GeorgeStanov/Proiect1_ETTI/Plan de plantare/Plan_Plantare_432E_bb.jpg

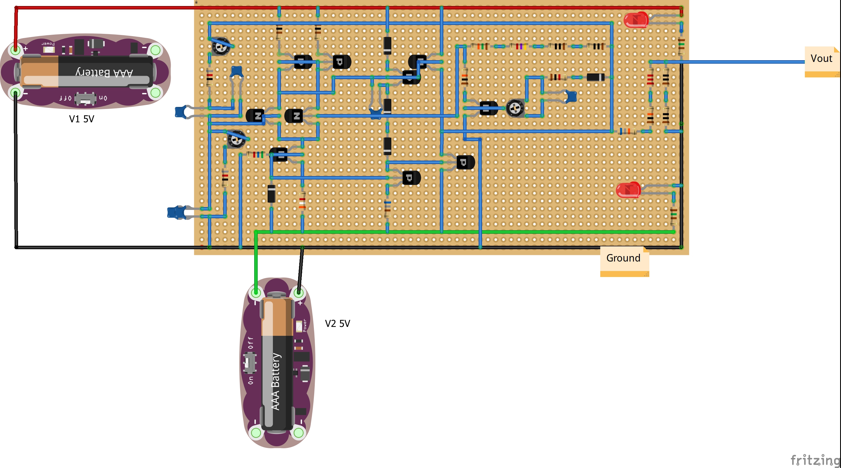
Plan de plantare/Plan_Plantare_432E_bb.jpg
