GeorgeStanov/Proiect1_ETTI/Proiect docs/Calcul analitic PSF.pdf

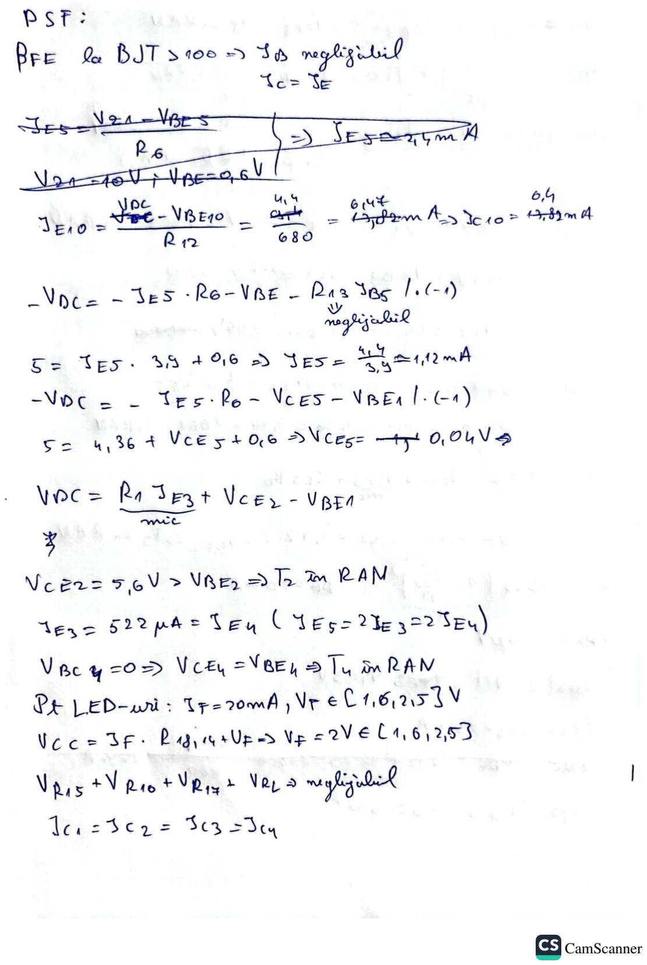
[picture p10: page 1]

CamScanner (https://v3.camscanner.com/user/download)

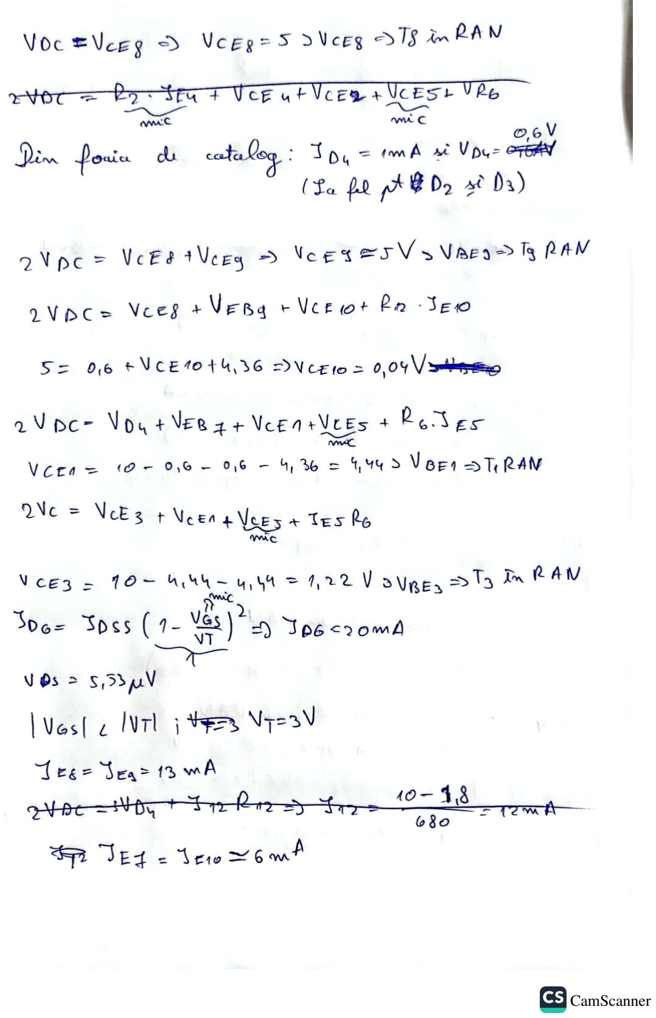
[picture p11: page 2]
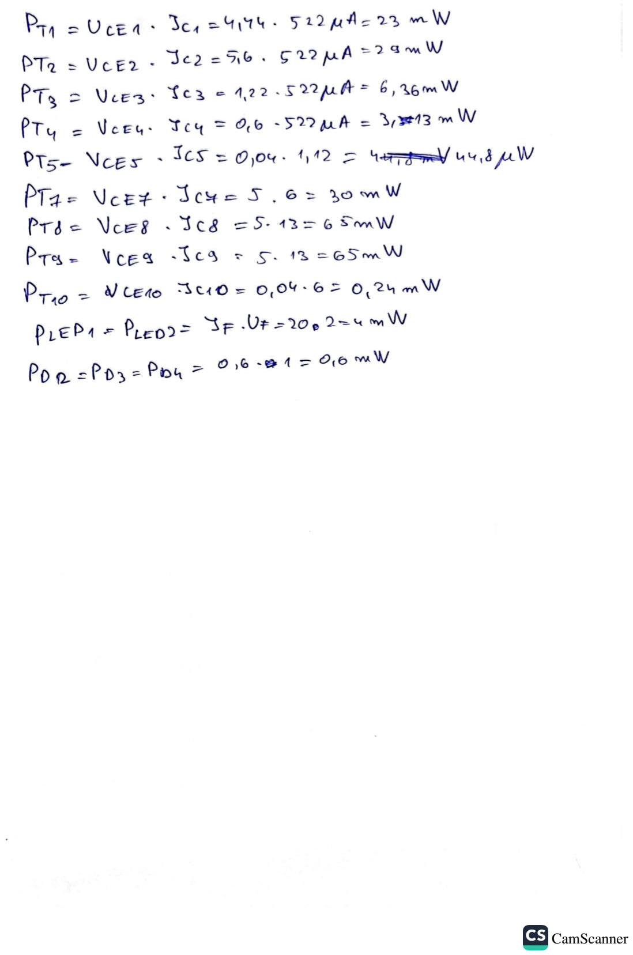
[picture p12: page 3]
