GeorgeStanov/Proiect1_ETTI/Proiect docs/Calcul curent alternativ.pdf

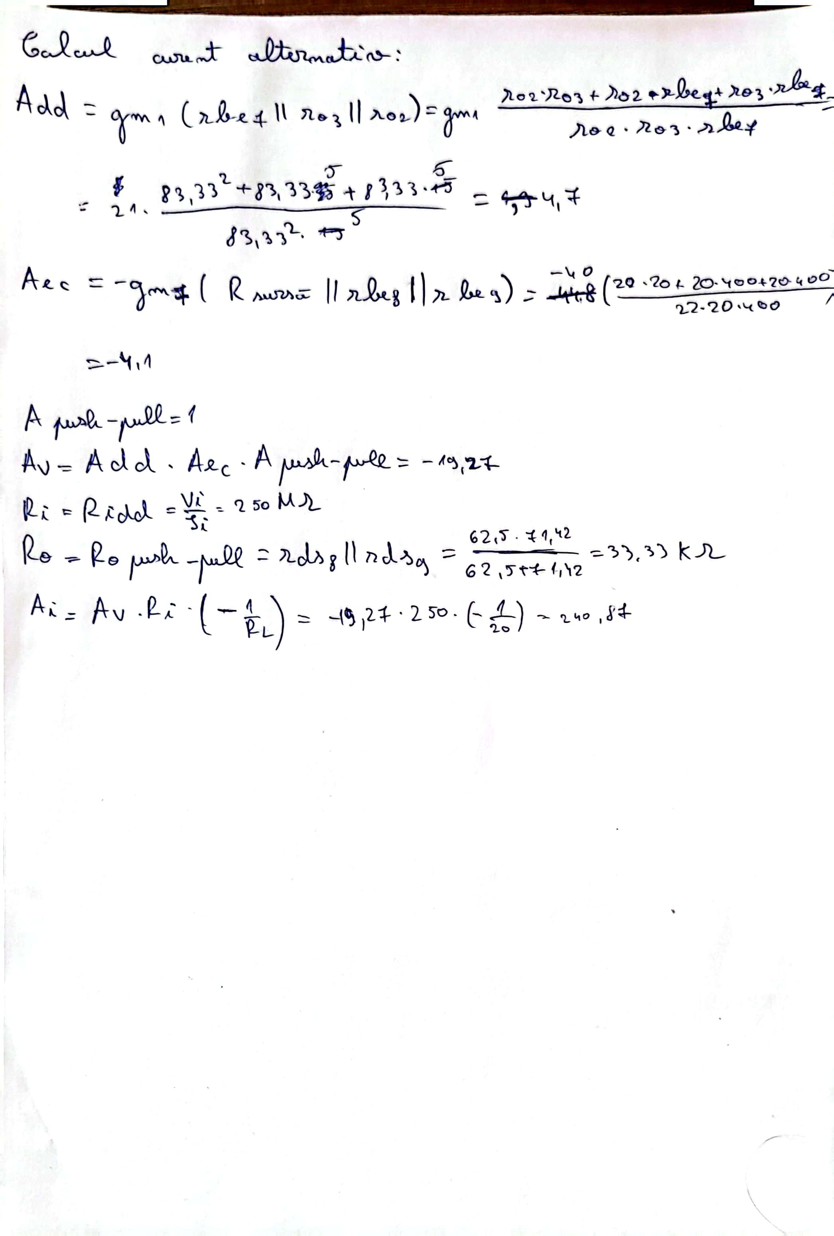
[picture p13: page 1]
