GeorgeStanov/Proiect1_ETTI/schema_bloc.png

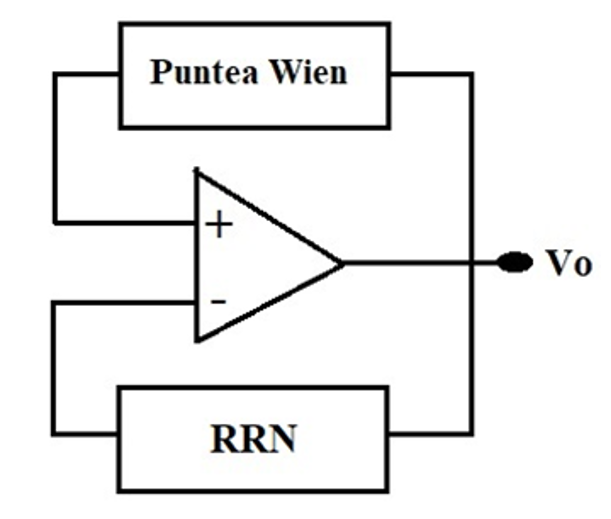
schema_bloc.png
