GeorgeStanov/Proiect1_ETTI/Schematics/schema electrica.png

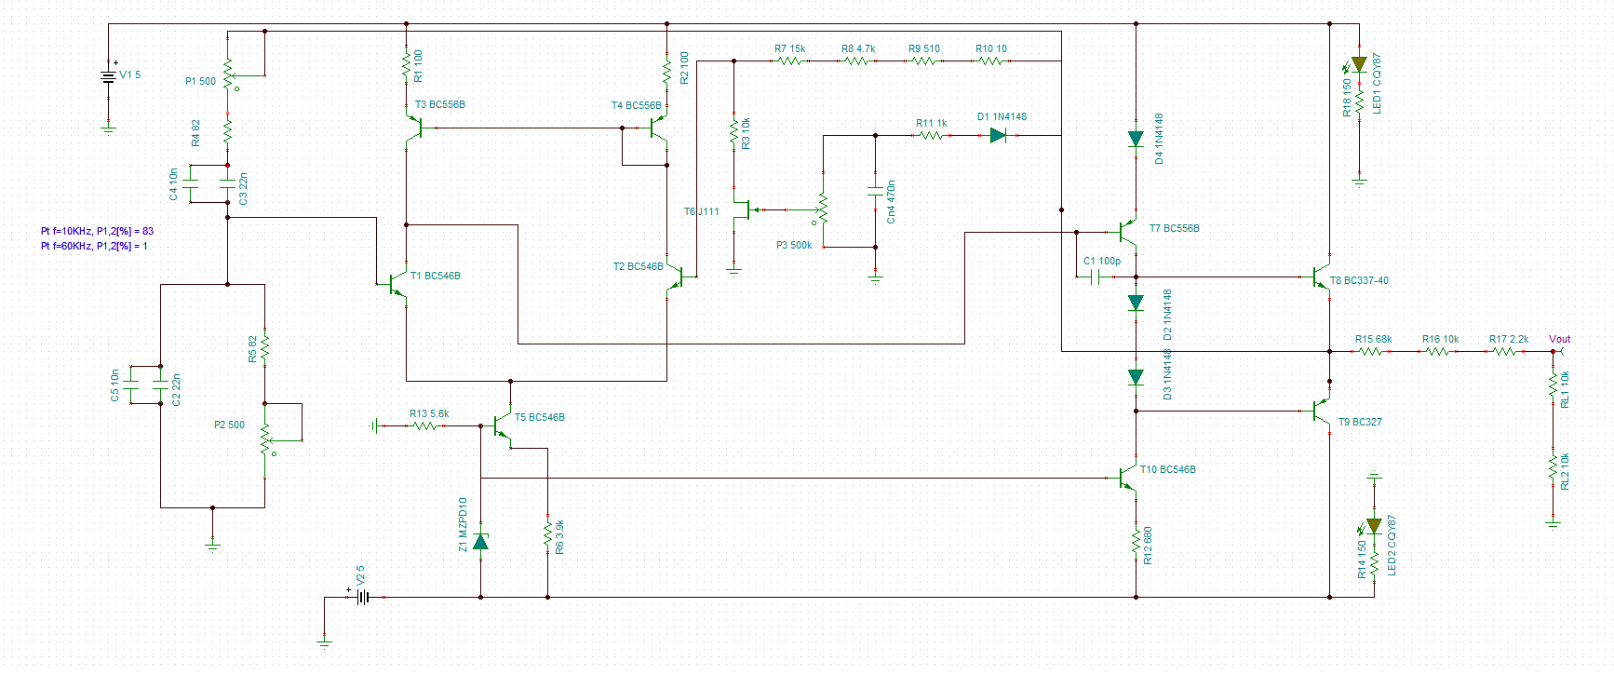
Schematics/schema electrica.png
