GeorgeStanov/Proiect1_ETTI/Schematics/schema_electrica.jpg

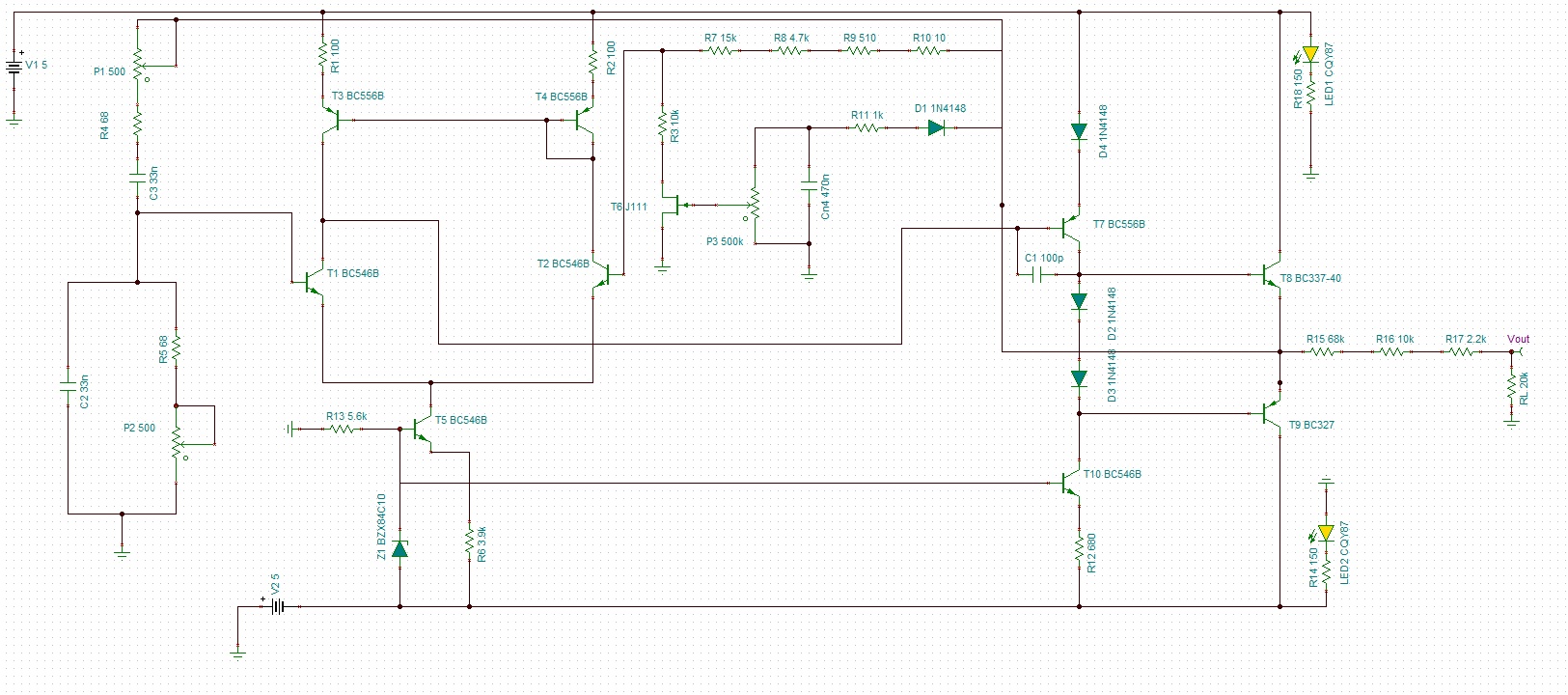
Schematics/schema_electrica.jpg
