GeorgeStanov/Proiect1_ETTI/Schematics/schema_electrica_CA.png

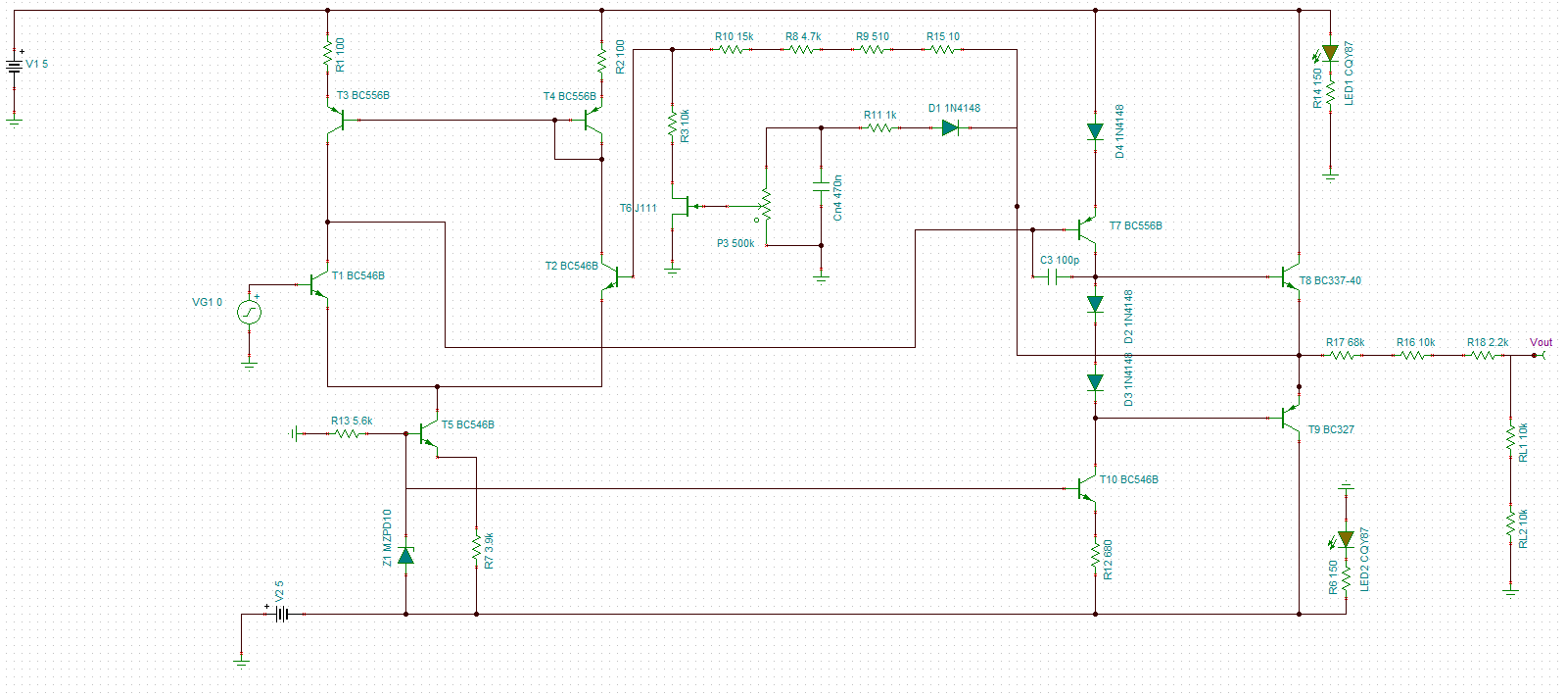
Schematics/schema_electrica_CA.png
