GeorgeStanov/Proiect1_ETTI/Simulations/forma de unda a semnalului de iesire pt fmin.png

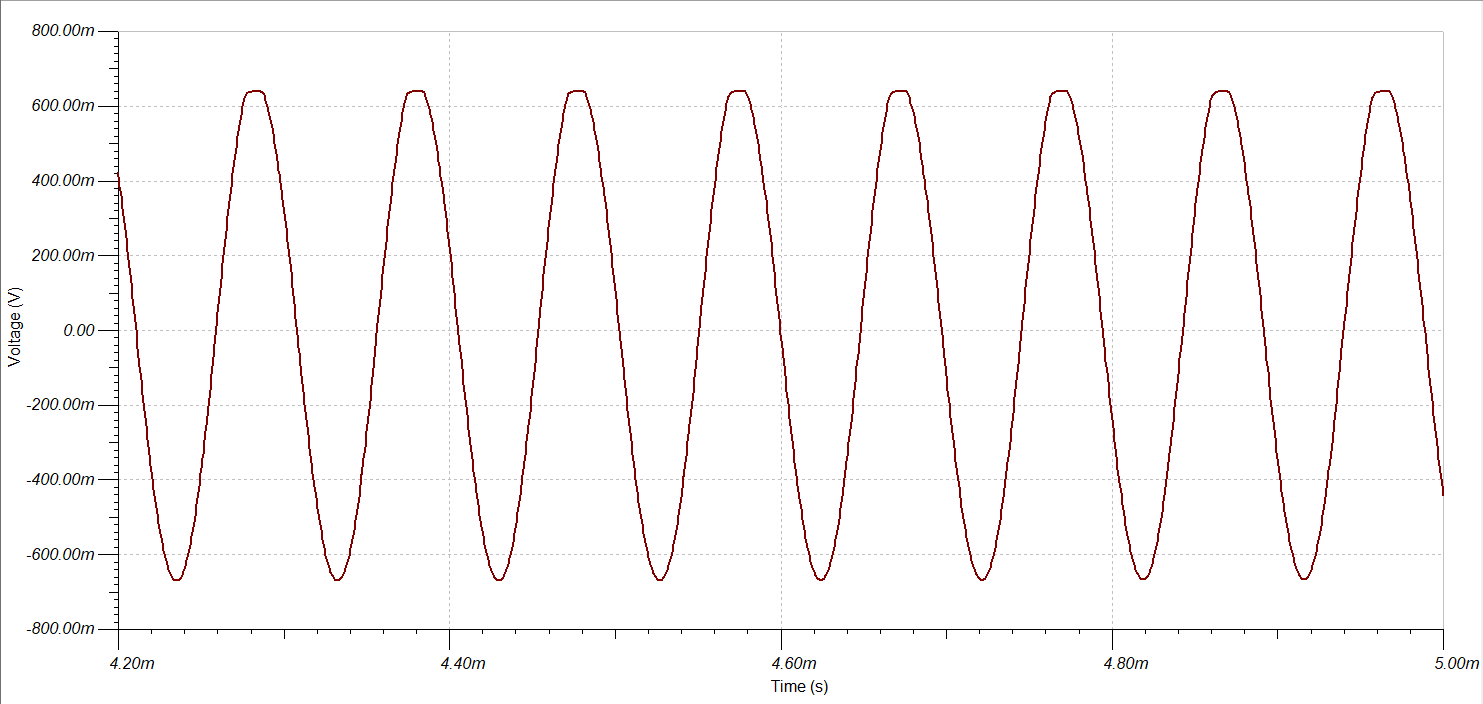
Simulations/forma de unda a semnalului de iesire pt fmin.png
