GeorgeStanov/Proiect1_ETTI/Simulations/Forma de undă a semnalului de ieșire pentru temperaturi cuprinse între -20 și 120 grade Celsius.png

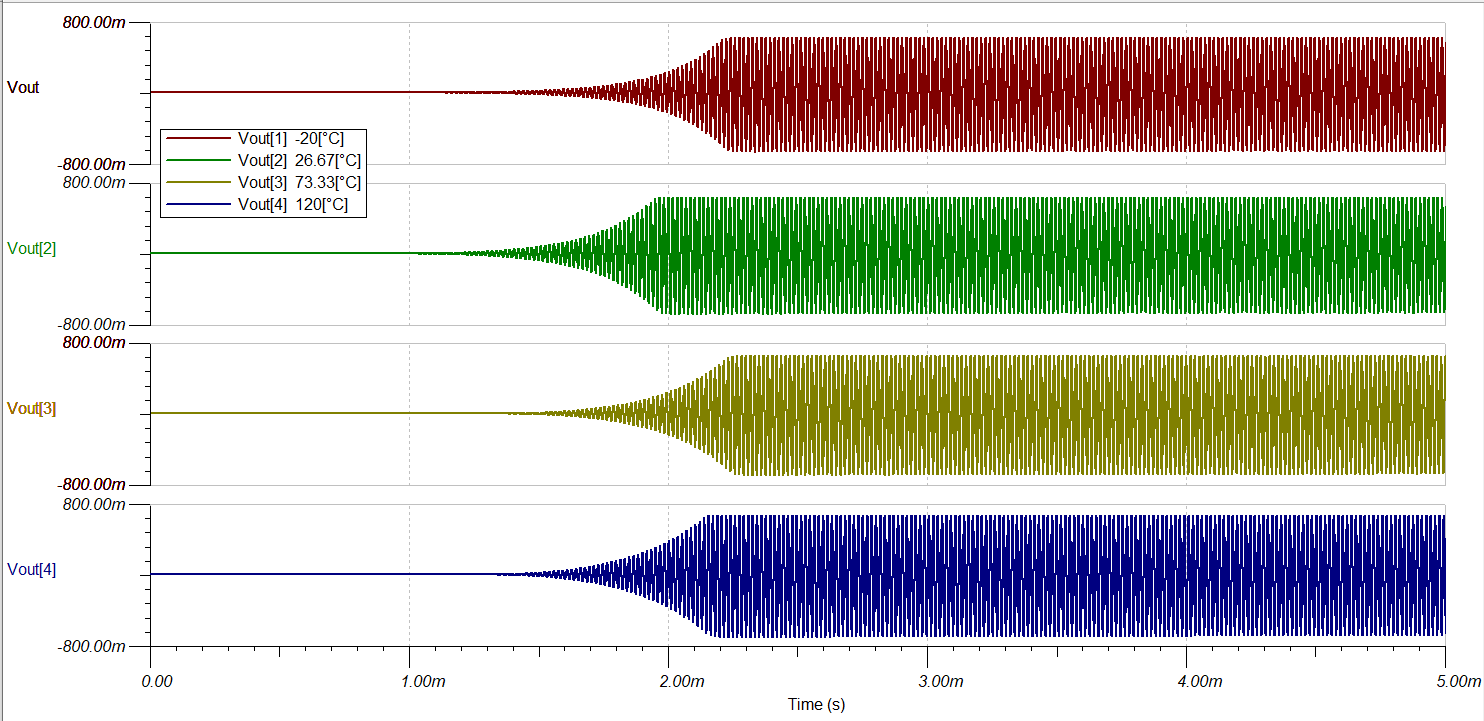
Simulations/Forma de undă a semnalului de ieșire pentru temperaturi cuprinse între -20 și 120 grade Celsius.png
