GeorgeStanov/Proiect1_ETTI/Simulations/Pornirea oscilațiilor și stabilizarea amplitudinii.jpg

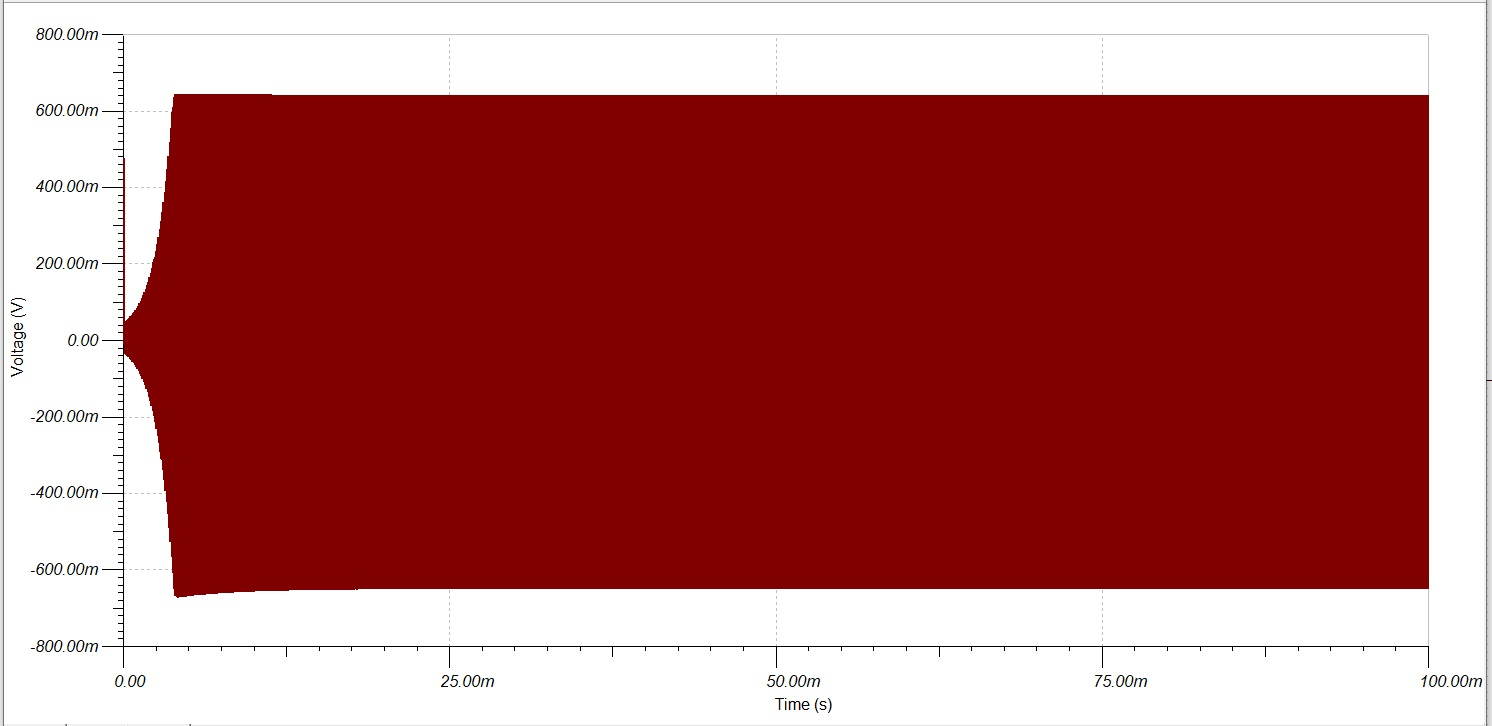
Simulations/Pornirea oscilațiilor și stabilizarea amplitudinii.jpg
