GeorgeStanov/Proiect1_ETTI/Simulations/Răspunsul în frecvență și faza circuitului în buclă deschisă.png

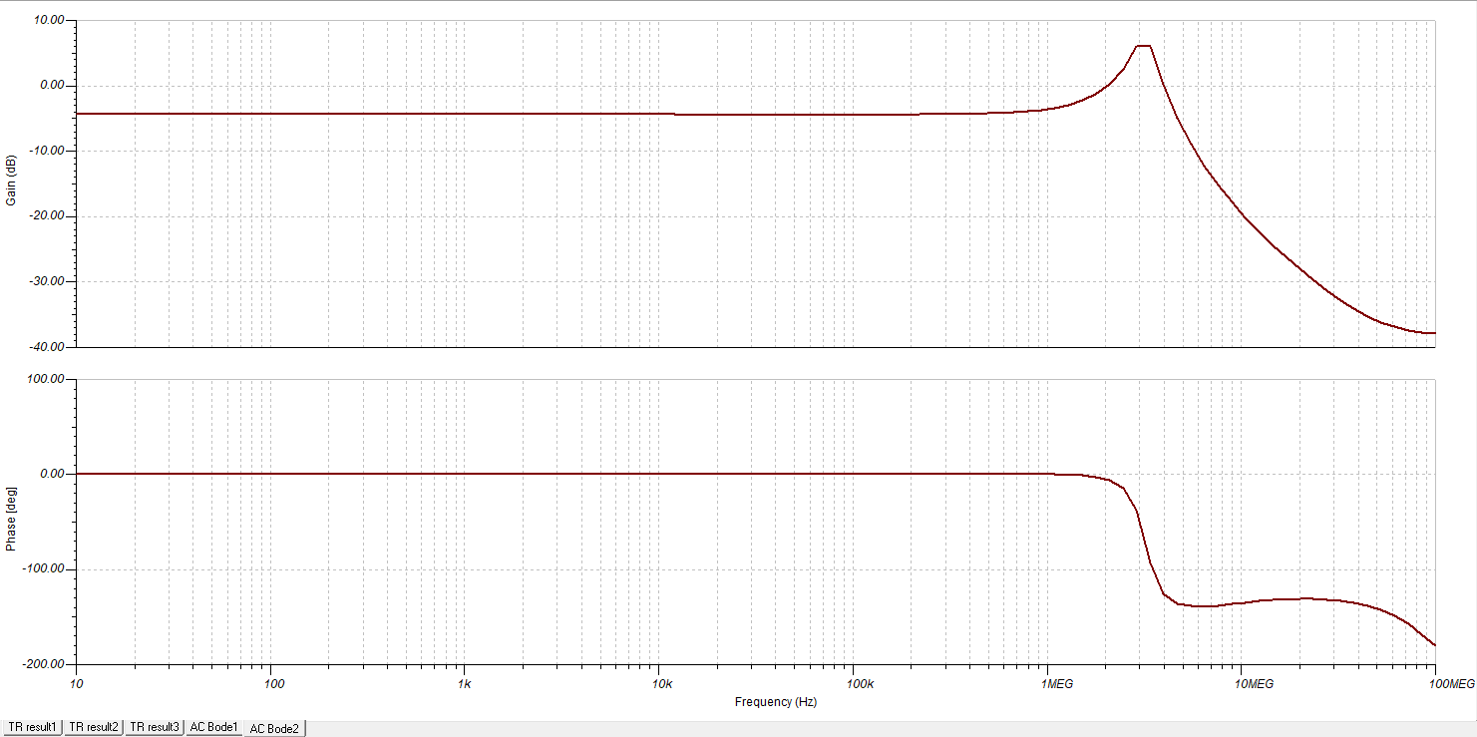
Simulations/Răspunsul în frecvență și faza circuitului în buclă deschisă.png
