GeorgeStanov/Proiect1_ETTI/Bill_of_Materials/Bill_of_Materials.xlsx

Anexa - Componente THD disponibile pentru realizarea proiectului P1 - tehnologie THT/Perfo-board - AU 2023-2024 Grupa 432E_Oscilator cu rețea Wien
Nr. Crt. | Nume | Catalog | Cod distrib | Nume prod | Prod | Clasă | Qty min | Descriere | Distribuitor
1 | 0 ohm | (LINK) (http://www.tme.eu/ro/details/smd1206-0r/rezistente-smd-1206/royal-ohm/1206s4j0000t5e/) |  |  |  | rezistor | 0 | indisponibil | TME România
2 | 0.47 | (LINK) (http://www.tme.eu/ro/details/smd0805-0r47/rezistente-smd-0805/royal-ohm/0805s8j047kt5e/) |  |  |  | rezistor | 0 | indisponibil | TME România
3 | 1 | (LINK) (https://www.tme.eu/ro/details/cf1_4w-1r/rezistente-carbon-tht-14w/sr-passives/) | THT; 1Ω; 0,25W; ±5% | CF1/4W-1R | SR PASSIVES | rezistor | 0 | Rezistor: de carbon; THT; 1Ω; 0,25W; ±5%; Ø2,3x6mm; Term: axial | TME România
4 | 4.7 | (LINK) (https://www.tme.eu/ro/details/cf1_4w-4r7/rezistente-carbon-tht-14w/sr-passives/) | THT; 4,7Ω; 0,25W; ±5% | CF1/4W-4R7 | SR PASSIVES | rezistor | 0 | Rezistor: de carbon; THT; 4,7Ω; 0,25W; ±5%; Ø2,3x6mm; Term: axial | TME România
5 | 10 | (LINK) (https://www.tme.eu/ro/details/1_4w10r/rezistente-carbon-tht-14w/royal-ohm/cfr0w4j0100a50/) | THT; 10Ω; 0,25W; ±5% | CFR0W4J0100A50 | ROYAL OHM | rezistor | 1 | Rezistor: de carbon; THT; 10Ω; 0,25W; ±5%; Ø2,5x6,8mm; Term: axial | TME România
6 | 22 | (LINK) (https://www.tme.eu/ro/details/cf1_4w-22r/rezistente-carbon-tht-14w/sr-passives/) | THT; 22Ω; 0,25W; ±5% | CF1/4W-22R | SR PASSIVES | rezistor | 0 | Rezistor: de carbon; THT; 22Ω; 0,25W; ±5%; Ø2,3x6mm; Term: axial | TME România
7 | 33 | (LINK) (https://www.tme.eu/ro/details/cf1_4w-33r/rezistente-carbon-tht-14w/sr-passives/) | THT; 33Ω; 0,25W; ±5% | CF1/4W-33R | SR PASSIVES | rezistor | 0 | Rezistor: de carbon; THT; 33Ω; 0,25W; ±5%; Ø2,3x6mm; Term: axial | TME România
8 | 51 | (LINK) (https://www.tme.eu/ro/details/1_4w51r/rezistente-carbon-tht-14w/royal-ohm/cfrw4j0510a50/) | THT; 51Ω; 0,25W; ±5% | CFRW4J0510A50 | ROYAL OHM | rezistor | 0 | Rezistor: de carbon; THT; 51Ω; 0,25W; ±5%; Ø2,5x6,8mm | TME România
9 | 68 | (LINK) (https://www.tme.eu/ro/details/1_4w68r/rezistente-carbon-tht-14w/royal-ohm/cfr0w4j0680a50/) | THT; 68Ω; 0,25W; ±5% | CFR0W4J0680A50 | ROYAL OHM | rezistor | 2 | Rezistor: de carbon; THT; 68Ω; 0,25W; ±5%; Ø2,5x6,8mm; Term: axial | TME România
10 | 82 | (LINK) (https://www.tme.eu/ro/details/cf1_4w-82r/rezistente-carbon-tht-14w/sr-passives/) | THT; 82Ω; 0,25W; ±5% | CF1/4W-82R | SR PASSIVES | rezistor | 0 | Rezistor: de carbon; THT; 82Ω; 0,25W; ±5%; Ø2,3x6mm; Term: axial | TME România
11 | 100 | (LINK) (https://www.tme.eu/ro/details/cf1_4w-100r/rezistente-carbon-tht-14w/sr-passives/) | THT; 100Ω; 0,25W; ±5% | CF1/4W-100R | SR PASSIVES | rezistor | 2 | Rezistor: de carbon; THT; 100Ω; 0,25W; ±5%; Ø2,3x6mm; Term: axial | TME România
12 | 150 | (LINK) (https://www.tme.eu/ro/details/cf1_4w-150r/rezistente-carbon-tht-14w/sr-passives/) | THT; 150Ω; 0,25W; ±5% | CF1/4W-150R | SR PASSIVES | rezistor | 2 | Rezistor: de carbon; THT; 150Ω; 0,25W; ±5%; Ø2,3x6mm; Term: axial | TME România
13 | 220 | (LINK) (https://www.tme.eu/ro/details/cf1_4w-220r/rezistente-carbon-tht-14w/sr-passives/) | THT; 220Ω; 0,25W; ±5% | CF1/4W-220R | SR PASSIVES | rezistor | 0 | Rezistor: de carbon; THT; 220Ω; 0,25W; ±5%; Ø2,3x6mm; Term: axial | TME România
14 | 330 | (LINK) (https://www.tme.eu/ro/details/cf1_4w-330r/rezistente-carbon-tht-14w/sr-passives/) | THT; 330Ω; 0,25W; ±5% | CF1/4W-330R | SR PASSIVES | rezistor | 0 | Rezistor: de carbon; THT; 330Ω; 0,25W; ±5%; Ø2,3x6mm; Term: axial | TME România
15 | 470 | (LINK) (https://www.tme.eu/ro/details/cf1_4w-470r/rezistente-carbon-tht-14w/sr-passives/) | THT; 470Ω; 0,25W; ±5% | CF1/4W-470R | SR PASSIVES | rezistor | 0 | Rezistor: de carbon; THT; 470Ω; 0,25W; ±5%; Ø2,3x6mm; Term: axial | TME România
16 | 510 | (LINK) (https://www.tme.eu/ro/details/cf1_4w-510r/rezistente-carbon-tht-14w/sr-passives/) | THT; 510Ω; 0,25W; ±5% | CF1/4W-510R | SR PASSIVES | rezistor | 1 | Rezistor: de carbon; THT; 510Ω; 0,25W; ±5%; Ø2,3x6mm; Term: axia | TME România
17 | 680 | (LINK) (https://www.tme.eu/ro/details/cf1_4w-680r/rezistente-carbon-tht-14w/sr-passives/) | THT; 680Ω; 0,25W; ±5% | CF1/4W-680R | SR PASSIVES | rezistor | 1 | Rezistor: de carbon; THT; 680Ω; 0,25W; ±5%; Ø2,3x6mm; Term: axial | TME România
18 | 820 | (LINK) (https://www.tme.eu/ro/details/cf1_4w-820r/rezistente-carbon-tht-14w/sr-passives/) | THT; 820Ω; 0,25W; ±5% | CF1/4W-820R | SR PASSIVES | rezistor | 0 | Rezistor: de carbon; THT; 820Ω; 0,25W; ±5%; Ø2,3x6mm; Term: axia | TME România
19 | 910 | (LINK) (https://www.tme.eu/ro/details/cf1_4w-910r/rezistente-carbon-tht-14w/sr-passives/) | THT; 910Ω; 0,25W; ±5% | CF1/4W-910R | SR PASSIVES | rezistor | 0 | Rezistor: de carbon; THT; 910Ω; 0,25W; ±5%; Ø2,3x6mm; Term: axial | TME România
20 | 1k | (LINK) (https://www.tme.eu/ro/details/cf1_4w-1k/rezistente-carbon-tht-14w/sr-passives/) | THT; 1kΩ; 0,25W; ±5% | CF1/4W-1K | SR PASSIVES | rezistor | 1 | Rezistor: de carbon; THT; 1kΩ; 0,25W; ±5%; Ø2,3x6mm; Term: axial | TME România
21 | 1.5k | (LINK) (https://www.tme.eu/ro/details/cf1_4w-1k5/rezistente-carbon-tht-14w/sr-passives/) | THT; 1,5kΩ; 0,25W; ±5% | CF1/4W-1K5 | SR PASSIVES | rezistor | 0 | Rezistor: de carbon; THT; 1,5kΩ; 0,25W; ±5%; Ø2,3x6mm; Term: axial | TME România
22 | 1.8k | (LINK) (https://www.tme.eu/ro/details/cf1_4w-1k8/rezistente-carbon-tht-14w/sr-passives/) | THT; 1,8kΩ; 0,25W; ±5% | CF1/4W-1K8 | SR PASSIVES | rezistor | 0 | Rezistor: de carbon; THT; 1,8kΩ; 0,25W; ±5%; Ø2,3x6mm; Term: axial | TME România
23 | 2k | (LINK) (https://www.tme.eu/ro/details/cf1_4w-2k/rezistente-carbon-tht-14w/sr-passives/) | THT; 2kΩ; 0,25W; ±5% | CF1/4W-2K | SR PASSIVES | rezistor | 0 | Rezistor: de carbon; THT; 2kΩ; 0,25W; ±5%; Ø2,3x6mm; Term: axial | TME România
24 | 2.2k | (LINK) (https://www.tme.eu/ro/details/cf1_4w-2k2/rezistente-carbon-tht-14w/sr-passives/) | THT; 2,2kΩ; 0,25W; ±5% | CF1/4W-2K2 | SR PASSIVES | rezistor | 1 | Rezistor: de carbon; THT; 2,2kΩ; 0,25W; ±5%; Ø2,3x6mm; Term: axial | TME România
25 | 2.7k | (LINK) (https://www.tme.eu/ro/details/cf1_4w-2k7/rezistente-carbon-tht-14w/sr-passives/) | THT; 2,7kΩ; 0,25W; ±5% | CF1/4W-2K7 | SR PASSIVES | rezistor | 0 | Rezistor: de carbon; THT; 2,7kΩ; 0,25W; ±5%; Ø2,3x6mm; Term: axial | TME România
26 | 3.3k | (LINK) (https://www.tme.eu/ro/details/cf1_4w-3k3/rezistente-carbon-tht-14w/sr-passives/) | THT; 3,3kΩ; 0,25W; ±5% | CF1/4W-3K3 | SR PASSIVES | rezistor | 0 | Rezistor: de carbon; THT; 3,3kΩ; 0,25W; ±5%; Ø2,3x6mm; Term: axial | TME România
27 | 3.9k | (LINK) (https://www.tme.eu/ro/details/cf1_4w-3k9/rezistente-carbon-tht-14w/sr-passives/) | THT; 3,9kΩ; 0,25W; ±5% | CF1/4W-3K9 | SR PASSIVES | rezistor | 1 | Rezistor: de carbon; THT; 3,9kΩ; 0,25W; ±5%; Ø2,3x6mm; Term: axial | TME România
28 | 4.7k | (LINK) (https://www.tme.eu/ro/details/cf1_4w-4k7/rezistente-carbon-tht-14w/sr-passives/) | THT; 4,7kΩ; 0,25W; ±5% | CF1/4W-4K7 | SR PASSIVES | rezistor | 1 | Rezistor: de carbon; THT; 4,7kΩ; 0,25W; ±5%; Ø2,3x6mm; Term: axial | TME România
29 | 5.6k | (LINK) (https://www.tme.eu/ro/details/cf1_4w-5k6/rezistente-carbon-tht-14w/sr-passives/) | THT; 5,6kΩ; 0,25W; ±5% | CF1/4W-5K6 | SR PASSIVES | rezistor | 1 | Rezistor: de carbon; THT; 5,6kΩ; 0,25W; ±5%; Ø2,3x6mm; Term: axial | TME România
30 | 6.8k | (LINK) (https://www.tme.eu/ro/details/cf1_4w-6k8/rezistente-carbon-tht-14w/sr-passives/) | THT; 6,8kΩ; 0,25W; ±5% | CF1/4W-6K8 | SR PASSIVES | rezistor | 0 | Rezistor: de carbon; THT; 6,8kΩ; 0,25W; ±5%; Ø2,3x6mm; Term: axial | TME România
31 | 8.2k | (LINK) (https://www.tme.eu/ro/details/cf1_4w-8k2/rezistente-carbon-tht-14w/sr-passives/) | THT; 8,2kΩ; 0,25W; ±5% | CF1/4W-8K2 | SR PASSIVES | rezistor | 0 | Rezistor: de carbon; THT; 8,2kΩ; 0,25W; ±5%; Ø2,3x6mm; Term: axial | TME România
32 | 9.1k | (LINK) (https://www.tme.eu/ro/details/cf1_4w-9k1/rezistente-carbon-tht-14w/sr-passives/) | THT; 9,1kΩ; 0,25W; ±5% | CF1/4W-9K1 | SR PASSIVES | rezistor | 0 | Rezistor: de carbon; THT; 9,1kΩ; 0,25W; ±5%; Ø2,3x6mm; Term: axial | TME România
33 | 10k | (LINK) (https://www.tme.eu/ro/details/cf1_4w-10k/rezistente-carbon-tht-14w/sr-passives/) | THT; 10kΩ; 0,25W; ±5% | CF1/4W-10K | SR PASSIVES | rezistor | 2 | Rezistor: de carbon; THT; 10kΩ; 0,25W; ±5%; Ø2,3x6mm; Term: axial | TME România
34 | 15k | (LINK) (https://www.tme.eu/ro/details/cf1_4w-15k/rezistente-carbon-tht-14w/sr-passives/) | THT; 15kΩ; 0,25W; ±5% | CF1/4W-15K | SR PASSIVES | rezistor | 1 | Rezistor: de carbon; THT; 15kΩ; 0,25W; ±5%; Ø2,3x6mm; Term: axial | TME România
35 | 22k | (LINK) (https://www.tme.eu/ro/details/cf1_4w-22k/rezistente-carbon-tht-14w/sr-passives/) | THT; 22kΩ; 0,25W; ±5% | CF1/4W-22K | SR PASSIVES | rezistor | 0 | Rezistor: de carbon; THT; 22kΩ; 0,25W; ±5%; Ø2,3x6mm; Term: axial | TME România
36 | 47k | (LINK) (https://www.tme.eu/ro/details/cf1_4w-47k/rezistente-carbon-tht-14w/sr-passives/) | THT; 47kΩ; 0,25W; ±5% | CF1/4W-47K | SR PASSIVES | rezistor | 0 | Rezistor: de carbon; THT; 47kΩ; 0,25W; ±5%; Ø2,3x6mm; Term: axial | TME România
37 | 68k | (LINK) (https://www.tme.eu/ro/details/cf1_4w-68k/rezistente-carbon-tht-14w/sr-passives/) | THT; 68kΩ; 0,25W; ±5% | CF1/4W-68K | SR PASSIVES | rezistor | 1 | Rezistor: de carbon; THT; 68kΩ; 0,25W; ±5%; Ø2,3x6mm; Term: axial | TME România
38 | 100k | (LINK) (https://www.tme.eu/ro/details/cf1_4w-100k/rezistente-carbon-tht-14w/sr-passives/) | THT; 100kΩ; 0,25W; ±5% | CF1/4W-100K | SR PASSIVES | rezistor | 0 | Rezistor: de carbon; THT; 100kΩ; 0,25W; ±5%; Ø2,3x6mm; Term: axial | TME România
39 | 150k | (LINK) (https://www.tme.eu/ro/details/cf1_4w-150k/rezistente-carbon-tht-14w/sr-passives/) | THT; 150kΩ; 0,25W; ±5% | CF1/4W-150K | SR PASSIVES | rezistor | 0 | Rezistor: de carbon; THT; 150kΩ; 0,25W; ±5%; Ø2,3x6mm; Term: axial | TME România
40 | 180k | (LINK) (https://www.tme.eu/ro/details/cf1_4w-180k/rezistente-carbon-tht-14w/sr-passives/) | THT; 180kΩ; 0,25W; ±5% | CF1/4W-180K | SR PASSIVES | rezistor | 0 | Rezistor: de carbon; THT; 180kΩ; 0,25W; ±5%; Ø2,3x6mm; Term: axial | TME România
41 | 220k | (LINK) (https://www.tme.eu/ro/details/cf1_4w-220k/rezistente-carbon-tht-14w/sr-passives/) | THT; 220kΩ; 0,25W; ±5% | CF1/4W-220K | SR PASSIVES | rezistor | 0 | Rezistor: de carbon; THT; 220kΩ; 0,25W; ±5%; Ø2,3x6mm; Term: axial | TME România
42 | 330k | (LINK) (https://www.tme.eu/ro/details/cf1_4w-330k/rezistente-carbon-tht-14w/sr-passives/) | THT; 330kΩ; 0,25W; ±5% | CF1/4W-330K | SR PASSIVES | rezistor | 0 | Rezistor: de carbon; THT; 330kΩ; 0,25W; ±5%; Ø2,3x6mm; Term: axial | TME România
43 | 390k | (LINK) (https://www.tme.eu/ro/details/cf1_4w-390k/rezistente-carbon-tht-14w/sr-passives/) | THT; 390kΩ; 0,25W; ±5% | CF1/4W-390K | SR PASSIVES | rezistor | 0 | Rezistor: de carbon; THT; 390kΩ; 0,25W; ±5%; Ø2,3x6mm; Term: axial | TME România
44 | 510k | (LINK) (https://www.tme.eu/ro/details/cf1_4w-510k/rezistente-carbon-tht-14w/sr-passives/) | THT; 510kΩ; 0,25W; ±5% | CF1/4W-510K | SR PASSIVES | rezistor | 0 | Rezistor: de carbon; THT; 510kΩ; 0,25W; ±5%; Ø2,3x6mm; Term: axial | TME România
45 | 20k | (LINK) (https://www.tme.eu/ro/details/acs-5s-20k-j/rezistente-de-putere/arcol/acs5s-20k-j-tr/) | THT; 20kΩ; 5W; ±5% | ACS5S 20K J TR | ARCOL | rezistor | 1 | Rezistor: bobinat; THT; 20kΩ; 5W; ±5%; Ø4,8x12,7mm | TME România
46 | 2M | (LINK) (https://www.tme.eu/ro/details/cf1_4w-2m/rezistente-carbon-tht-14w/sr-passives/) | THT; 2MΩ; 0,25W; ±5% | CF1/4W-2M | SR PASSIVES | rezistor | 0 | Rezistor: de carbon; THT; 2MΩ; 0,25W; ±5%; Ø2,3x6mm; Term: axial | TME România
47 | 5,1M | (LINK) (https://www.tme.eu/ro/details/cf1_4w-5m1/rezistente-carbon-tht-14w/sr-passives/) | THT; 5,1MΩ; 0,25W; ±5% | CF1/4W-5M1 | SR PASSIVES | rezistor | 0 | Rezistor: de carbon; THT; 5,1MΩ; 0,25W; ±5%; Ø2,3x6mm; Term: axial | TME România
48 | 10M | (LINK) (https://www.tme.eu/ro/details/cf1_4w-10m/rezistente-carbon-tht-14w/sr-passives/) | THT; 10MΩ; 0,25W; ±5% | CF1/4W-10M | SR PASSIVES | rezistor | 0 | Rezistor: de carbon; THT; 10MΩ; 0,25W; ±5%; Ø2,3x6mm; Term: axial | TME România
49 | 100ohm | (LINK) (https://www.tme.eu/ro/details/3319p-1-101/trimere-tht-cu-o-singura-tura/bourns/) | 3319P-1-101 | 3319P-1-101 | BOURNS | potențiometru | 0 | Potenţiometru: de montare; singură tură, orizontal; 100Ω; 200mW | TME România
50 | 500ohm | (LINK) (https://www.tme.eu/ro/details/t75w-500r/trimere-tht-cu-o-singura-tura/sr-passives/) | T75W-500R | T75W-500R | SR PASSIVES | potențiometru | 2 | Potenţiometru: de montare; singură tură, vertical; 500Ω; 250mW | TME România
51 | 2k | (LINK) (https://www.tme.eu/ro/details/t75r-2k/trimere-tht-cu-o-singura-tura/sr-passives/) | T75R-2K | T75R-2K | SR PASSIVES | potențiometru | 0 | Potenţiometru: de montare; singură tură, orizontal; 2kΩ; 250mW | TME România
52 | 5k | (LINK) (https://www.tme.eu/ro/details/t75r-5k/trimere-tht-cu-o-singura-tura/sr-passives/) | T75R-5K | T75R-5K | SR PASSIVES | potențiometru | 0 | Potenţiometru: de montare; singură tură, orizontal; 5kΩ; 250mW | TME România
53 | 10k | (LINK) (https://www.tme.eu/ro/details/t75r-10k/trimere-tht-cu-o-singura-tura/sr-passives/) | T75R-10K | T75R-10K | SR PASSIVES | potențiometru | 0 | Potenţiometru: de montare; singură tură, orizontal; 10kΩ; 250mW | TME România
54 | 50k | (LINK) (https://www.tme.eu/ro/details/t75w-50k/trimere-tht-cu-o-singura-tura/sr-passives/) | T75W-50K | T75W-50K | SR PASSIVES | potențiometru | 0 | Potenţiometru: de montare; singură tură, orizontal; 50kΩ; 250mW | TME România
55 | 100k | (LINK) (https://www.tme.eu/ro/details/t75r-100k/trimere-tht-cu-o-singura-tura/sr-passives/) | T75R-100K | T75R-100K | SR PASSIVES | potențiometru | 0 | Potenţiometru: de montare; singură tură, orizontal; 100kΩ; 250mW | TME România
56 | 500k | (LINK) (https://www.tme.eu/ro/details/ca14v-500k/trimere-tht-cu-o-singura-tura/acp/ca14nv125-500ka2020/) | CA14NV12,5-500KA2020 | CA14V-500K | ACP | potențiometru | 1 | Potenţiometru: de montare; singură tură, orizontal; 500kΩ; 250mW | TME România
 | TOTAL - Componente pasive (rezistoare de valori fixe şi reglabile) |  |  |  |  |  |  | FARA TVA = | 0
57 | 33nF | (LINK) (https://www.tme.eu/ro/details/cm-33n/condensatoare-mlcc-tht/sr-passives/) | CM-33N | CCK-4P7 | SR PASSIVES | condensator | 2 | Condensator: ceramic; 33nF; 50V; Z5U; ±20%; THT; 5mm | TME România
58 | 10pF | (LINK) (https://www.tme.eu/ro/details/cck-10p/condensatoare-ceramice-tht-100v/sr-passives/) | CCK-10P | CCK-10P | SR PASSIVES | condensator | 0 | Condensator: ceramic; 10pF; 100V; C0G; ±5%; THT; 5mm | TME România
59 | 47pF | (LINK) (https://www.tme.eu/ro/details/cck-47p/condensatoare-ceramice-tht-100v/sr-passives/) | CCK-47P | CCK-47P | SR PASSIVES | condensator | 0 | Condensator: ceramic; 47pF; 100V; P350-N1000; ±5%; THT; 5mm | TME România
60 | 100pF | (LINK) (https://www.tme.eu/ro/details/cck-100p/condensatoare-ceramice-tht-100v/sr-passives/) | CCK-100P | CCK-100P | SR PASSIVES | condensator | 1 | Condensator: ceramic; 100pF; 100V; P350-N1000; ±5%; THT; 5mm | TME România
61 | 470pF | (LINK) (https://www.tme.eu/ro/details/cck-470p/condensatoare-ceramice-tht-100v/sr-passives/) | CCK-470P | CCK-470P | SR PASSIVES | condensator | 0 | Condensator: ceramic; 470pF; 100V; Y5P; ±10%; THT; 5mm | TME România
62 | 1nF | (LINK) (https://www.tme.eu/ro/details/cck-1n/condensatoare-ceramice-tht-100v/sr-passives/) | CCK-1N | CCK-1N | SR PASSIVES | condensator | 0 | Condensator: ceramic; 1nF; 100V; Y5P; ±10%; THT; 5mm | TME România
63 | 2.2nF | (LINK) (https://www.tme.eu/ro/details/cck-2n2/condensatoare-ceramice-tht-100v/sr-passives/) | CCK-2N2 | CCK-2N2 | SR PASSIVES | condensator | 2 | Condensator: ceramic; 2,2nF; 100V; Y5P; ±10%; THT; 5mm | TME România
64 | 4.7nF | (LINK) (https://www.tme.eu/ro/details/cck-4n7/condensatoare-ceramice-tht-100v/sr-passives/) | CCK-4N7 | CCK-4N7 | SR PASSIVES | condensator | 0 | Condensator: ceramic; 4,7nF; 100V; Z5U; ±20%; THT; 5mm | TME România
65 | 6.8nF | (LINK) (https://www.tme.eu/ro/details/cck-6n8/condensatoare-ceramice-tht-100v/sr-passives/) | CCK-6N8 | CCK-6N8 | SR PASSIVES | condensator | 0 | Condensator: ceramic; 6,8nF; 100V; Y5V; -20÷+80%; THT; 5mm | TME România
66 | 10nF | (LINK) (https://www.tme.eu/ro/details/cck-10n/condensatoare-ceramice-tht-100v/sr-passives/) | CCK-10N | CCK-10N | SR PASSIVES | condensator | 0 | Condensator: ceramic; 10nF; 100V; Y5V; -20÷+80%; THT; 5mm | TME România
67 | 22nF | (LINK) (https://www.tme.eu/ro/details/cck-22n/condensatoare-ceramice-tht-100v/sr-passives/) | CCK-22N | CCK-22N | SR PASSIVES | condensator | 0 | Condensator: ceramic; 22nF; 100V; Y5V; -20÷+80%; THT; 5mm | TME România
68 | 47nF | (LINK) (https://www.tme.eu/ro/details/cck-47n/condensatoare-ceramice-tht-100v/sr-passives/) | CCK-47N | CCK-47N | SR PASSIVES | condensator | 0 | Condensator: ceramic; 47nF; 100V; Y5V; -20÷+80%; THT; 5mm | TME România
69 | 100nF | (LINK) (https://www.tme.eu/ro/details/cck-100n/condensatoare-ceramice-tht-100v/sr-passives/) | CCK-100N | CCK-100N | SR PASSIVES | condensator | 0 | Condensator: ceramic; 100nF; 100V; Y5V; -20÷+80%; THT; 5mm | TME România
70 | 220nF | (LINK) (https://www.tme.eu/ro/details/cm-220n-y5v/condensatoare-mlcc-tht/sr-passives/) | CM-220N-Y5V | CM-220N-Y5V | SR PASSIVES | condensator | 0 | Condensator: ceramic; 220nF; 50V; Y5V; ±10%; THT; 5mm; Ambalaj: bandă | TME România
71 | 330nF | (LINK) (https://www.tme.eu/ro/details/cm-330n/condensatoare-mlcc-tht/sr-passives/) | CM-330N | CM-330N | SR PASSIVES | condensator | 0 | Condensator: ceramic; 330nF; 50V; Y5V; ±10%; THT; 5mm; Ambalaj: bandă | TME România
72 | 470nF | (LINK) (https://www.tme.eu/ro/details/cm-470n-y5v_50-t/condensatoare-mlcc-tht/sr-passives/) | CM-470N-Y5V/50-T | CM-470N-Y5V/50-T | SR PASSIVES | condensator | 1 | Condensator: ceramic; 470nF; 50V; Y5V; ±10%; THT; 5mm; Ambalaj: bandă | TME România
73 | 1uF | (LINK) (https://www.tme.eu/ro/details/cm-1u-y5v/condensatoare-mlcc-tht/sr-passives/) | CM-1U-Y5V | CM-1U-Y5V | SR PASSIVES | condensator | 0 | Condensator: ceramic; MLCC, monolitic; 1uF; 50V; Y5V; -80÷+22%; THT | TME România
74 | 4.7uF | (LINK) (https://www.tme.eu/ro/details/ss1h475m04007pa18p/condensatoare-electrolitice-tht-85c/samwha/) | SS1H475M04007PA18P | SS1H475M04007PA18P | SAMWHA | condensator | 0 | Condensator: electrolitic; THT; 4,7uF; 50VDC; Ø4x7mm; Raster:1,5mm | TME România
75 | 10uF | (LINK) (https://www.tme.eu/ro/details/ce-10_16sp/condensatoare-electrolitice-tht-85c/sr-passives/) | CE-10/16SP | CE-10/16SP | SR PASSIVES | condensator | 0 | Condensator: electrolitic; THT; 10uF; 16VDC; Ø4x7mm; Raster:1,5mm | TME România
76 | 100uF | (LINK) (https://www.tme.eu/ro/details/uvr1h101mpd/condensatoare-electrolitice-tht-85c/nichicon/) | UVR1H101MPD | UVR1H101MPD | NICHICON | condensator | 0 | Condensator: electrolitic; THT; 100uF; 50VDC; Ø8x11,5mm; ±20% | TME România
 | TOTAL - Componente pasive (condensatoare) |  |  |  |  |  |  | FARA TVA = | 0
77 | 4148 | (LINK) (https://www.tme.eu/ro/details/1n4148-tap/diode-universale-tht/vishay/) | 1N4148-TAP | 1N4148-TAP | VISHAY | diodă pn | 4 | Diodă: comutaţie; THT; 100V; 300mA; Ambalaj: Ammo Pack; DO35 | TME România
78 | LED | (LINK) (https://www.tme.eu/ro/details/ll-204vd2a-v1-2b/led-uri-tht-18mm/lucky-light/) | LL-204VD2A-V1-2B | LL-204VD2A-V1-2B | LUCKY LIGHT | LED | 2 | LED; 1,8mm; roşie; 200-300mcd; 55°; 1,6÷2,5V | TME România
79 | 2.7V | (LINK) (https://www.tme.eu/ro/details/zpd2.7-dio/diode-zener-tht/diotec-semiconductor/zpd27/) | ZPD2.7-DIO | ZPD2.7 | DIOTEC SEMICONDUCTOR | diodă Zener | 0 | Diodă: Zener; 0,5W; 2,7V; Ambalaj: Ammo Pack; DO35 | TME România
80 | 5.1V | (LINK) (https://www.tme.eu/ro/details/zpd5.1-dio/diode-zener-tht/diotec-semiconductor/zpd51/) | ZPD5.1-DIO | ZPD5.1 | DIOTEC SEMICONDUCTOR | diodă Zener | 0 | Diodă: Zener; 0,5W; 5,1V; Ambalaj: Ammo Pack; DO35 | TME România
81 | 5.6V | (LINK) (https://www.tme.eu/ro/details/zpd5.6-dio/diode-zener-tht/diotec-semiconductor/zpd56/) | ZPD5.6-DIO | ZPD5.6 | DIOTEC SEMICONDUCTOR | diodă Zener | 0 | Diodă: Zener; 0,5W; 5,6V; Ambalaj: Ammo Pack; DO35 | TME România
82 | 6.2V | (LINK) (https://www.tme.eu/ro/details/zpd6.2-dio/diode-zener-tht/diotec-semiconductor/zpd62/) | ZPD6.2-DIO | ZPD6.2 | DIOTEC SEMICONDUCTOR | diodă Zener | 0 | Diodă: Zener; 0,5W; 6,2V; Ambalaj: Ammo Pack; DO35 | TME România
83 | 6.8V | (LINK) (https://www.tme.eu/ro/details/zpd6.8-dio/diode-zener-tht/diotec-semiconductor/zpd68/) | ZPD6.8-DIO | ZPD6.8 | DIOTEC SEMICONDUCTOR | diodă Zener | 0 | Diodă: Zener; 0,5W; 6,8V; Ambalaj: Ammo Pack; DO35 | TME România
84 | 8.2V | (LINK) (https://www.tme.eu/ro/details/zpd8.2-dio/diode-zener-tht/diotec-semiconductor/zpd82/) | ZPD8.2-DIO | ZPD8.2 | DIOTEC SEMICONDUCTOR | diodă Zener | 0 | Diodă: Zener; 0,5W; 8,2V; Ambalaj: Ammo Pack; DO35 | TME România
85 | 10V | (LINK) (https://www.tme.eu/ro/details/zpd10-dio/diode-zener-tht/diotec-semiconductor/zpd10/) | ZPD10-DIO | ZPD10 | DIOTEC SEMICONDUCTOR | diodă Zener | 1 | Diodă: Zener; 0,5W; 10V; Ambalaj: Ammo Pack; DO35 | TME România
86 | PNP | (LINK) (https://www.tme.eu/ro/details/bc556bbk-dio/tranzistori-tht-pnp/diotec-semiconductor/bc556bbk/) | BC556BBK-DIO | BC556BBK | DIOTEC SEMICONDUCTOR | tranzistor bipolar | 3 | Tranzistor: PNP; bipolar; 65V; 100mA; 500mW; TO92 | TME România
87 | NPN | (LINK) (https://www.tme.eu/ro/details/bc546bbk-dio/tranzistori-tht-npn/diotec-semiconductor/bc546bbk/) | BC546BBK-DIO | BC546BBK | DIOTEC SEMICONDUCTOR | tranzistor bipolar | 4 | Tranzistor: NPN; bipolar; 65V; 100mA; 500mW; TO92 | TME România
89 | N-JFET | (LINK) (https://www.tme.eu/ro/details/j111/tranzistori-canal-n-tht/on-semiconductor-fairchild/) | J111 | J111 | ON SEMICONDUCTOR (FAIRCHILD) | tranzistor N-JFET | 1 | Tranzistor: N-JFET; unipolar; 35V; 20mA; 350mW; TO92 | TME România
90 | P-JFET | (LINK) (http://www.tme.eu/ro/details/mmbfj177lt1g/tranzistori-canal-p-smd/on-semiconductor/) | MMBFJ177LT1G | MMBFJ177LT1G | ON Semiconductor | tranzistor PJFET | 0 | Tranzistor P-JFET, SMD, SOT23, 30V, 20mA | TME România
91 | NPN | (LINK) (https://www.tme.eu/ro/details/bc337-40-dio/tranzistori-tht-npn/diotec-semiconductor/bc337-40/) | BC337-40-DIO | BC337-40 | DIOTEC SEMICONDUCTOR | tranzistor bipolar | 1 | Tranzistor: NPN; bipolar; 45V; 800mA; 625mW; TO92 | TME România
93 | PNP | (LINK) (https://www.tme.eu/ro/details/bc327-40-dio/tranzistori-tht-pnp/diotec-semiconductor/bc327-40/) | BC327-40-DIO | BC327-40 | DIOTEC SEMICONDUCTOR | tranzistor bipolar | 1 | Tranzistor: PNP; bipolar; 45V; 800mA; 625mW; TO92 | TME România
94 | NPN | (LINK) (https://www.tme.eu/ro/details/bd241c/tranzistori-tht-npn/st-microelectronics/) | BD241C | BD241C | ST MICROELECTRONICS | tranzistor bipolar | 0 | Tranzistor: NPN; bipolar; 100V; 3A; 40W; TO220 | TME România
96 | PNP | (LINK) (https://www.tme.eu/ro/details/tip32c/tranzistori-tht-pnp/st-microelectronics/) | TIP32C | TIP32C | ST MICROELECTRONICS | tranzistor bipolar | 0 | Tranzistor: PNP; bipolar; 100V; 3A; 40W; TO220 | TME România
97 | Nmos | (LINK) (https://www.tme.eu/ro/details/irfu120npbf/tranzistori-canal-n-tht/infineon-irf/) | IRFU120NPBF | IRFU120NPBF | INFINEON (IRF) | tranzistor NMOS | 0 | Tranzistor: N-MOSFET; unipolar; 100V; 9,1A; 39W; IPAK; HEXFET® | TME România
 | TOTAL - Componente semiconductoare (tranzistoare bipolare şi cu efect de câmp, diode, LED, etc.) |  |  |  |  |  |  | FARA TVA = | 0
98 | Conn2p |  |  |  |  |  | 0 | indisponibil | TME România
99 | FUSE |  |  |  |  |  | 0 | indisponibil | TME România
 | Total - Conectică, sigurante fuzibile, etc. |  |  |  |  |  |  | FARA TVA = | 0
 | Total general |  |  |  |  |  |  | FARA TVA = | 0
