GeorgeStanov/Proiect1_ETTI/Bill_of_Materials/BOM_exported.txt

#    Quantity	Label	Value	
1.	1	R10      10					
2.	1	R1	 100				
3.	1	R2	 100					
4.	1	C1	 100p	 				
5.	1	R16	 10k	 			
6.	1	R3	 10k					
7.	1	RL1	 10k	 				
8.	1	RL2	 10k					
9.	1	C4	 10n 				
10.	1	C5	 10n	 				
11.	1	R14	 150					
12.	1	R18	 150	 				
13.	1	R7	 15k	 				
14.	1	R11	 1k	 				
15.	1	D1	 1N4148	 				
16.	1	D2	 1N4148					
17.	1	D3	 1N4148					
18.	1	D4	 1N4148					
19.	1	R17	 2.2k	 				
20.	1	C2	 22n				
21.	1	C3	 22n				
22.	1	R6	 3.9k					
23.	1	R8	 4.7k					
24.	1	Cn4	 470n					
25.	1	R13	 5.6k						 				
26.	1	P1	 500					
27.	1	P2	 500					
28.	1	P3	 500k					
29.	1	R9	 510	 				
30.	1	R12	 680	 				
31.	1	R15	 68k					
32.	1	R4	 82					
33.	1	R5	 82					
34.	1	T9	 BC327					
35.	1	T8	 BC337-40					
36.	1	T1	 BC546B	 				
37.	1	T10	 BC546B					
38.	1	T2	 BC546B					
39.	1	T5	 BC546B					
40.	1	T3	 BC556B					
41.	1	T4	 BC556B					
42.	1	T7	 BC556B					
43.	1	LED1	 CQY87					
44.	1	LED2	 CQY87	 				
45.	1	T6	 J111				
46.	1	Z1	 MZPD10
