GeorgeStanov/Proiect1_ETTI/(list of files, drawings)

Other design files:
Plan de plantare/Plan_Plantare_432E.fzz
